zomerfeld/warm_n_fuzzies/(commit log)

2017-04-26 schematic and typo
2017-05-13 heatpad circuit
2017-05-13 MOSFET + IFTTT
